midarubiccube/motordriver_board/3D/AZ1117CH-3.3TRG1.stp

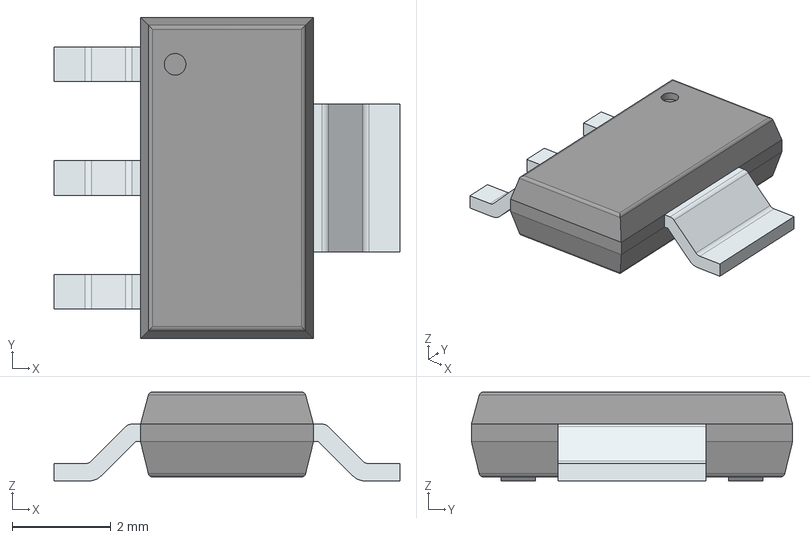
[picture p1: CAD file, 2024-08-10]
3D/AZ1117CH-3.3TRG1.stp
7.00 x 6.50 x 1.80 mm
PinsArrayL
FilletPinR
