midarubiccube/motordriver_board/3D/XT60PW-F--3DModel-STEP-510211.step

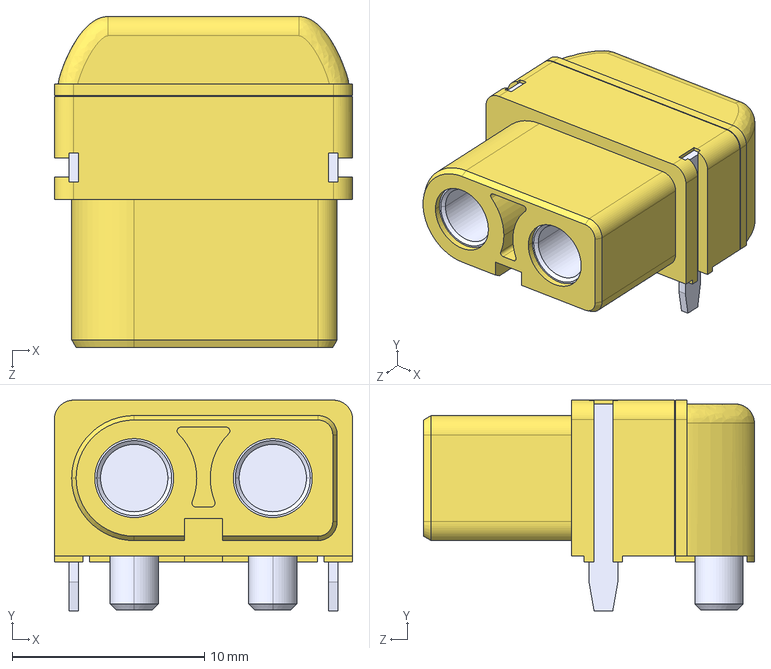
[picture p2: CAD file, 2024-08-10]
3D/XT60PW-F--3DModel-STEP-510211.step
15.5 x 10.9 x 17.2 mm
