midarubiccube/motordriver_board/3D/BP5293-50.stp

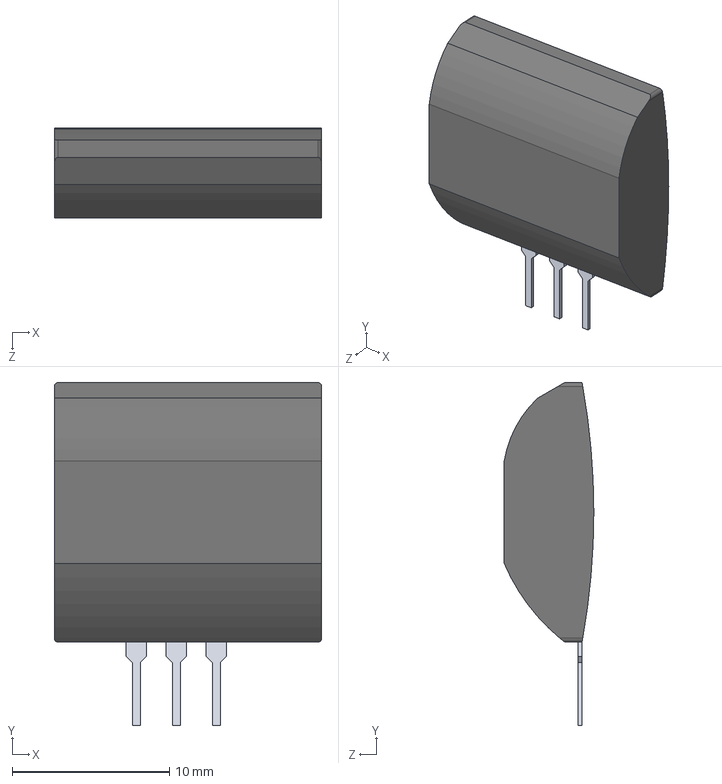
[picture p3: CAD file, 2024-08-10]
3D/BP5293-50.stp
17.0 x 21.8 x 5.70 mm
