midarubiccube/motordriver_board/motordriver_board.kicad_pcb

## KiCad design motordriver_board.kicad_pcb (2024-09-26)

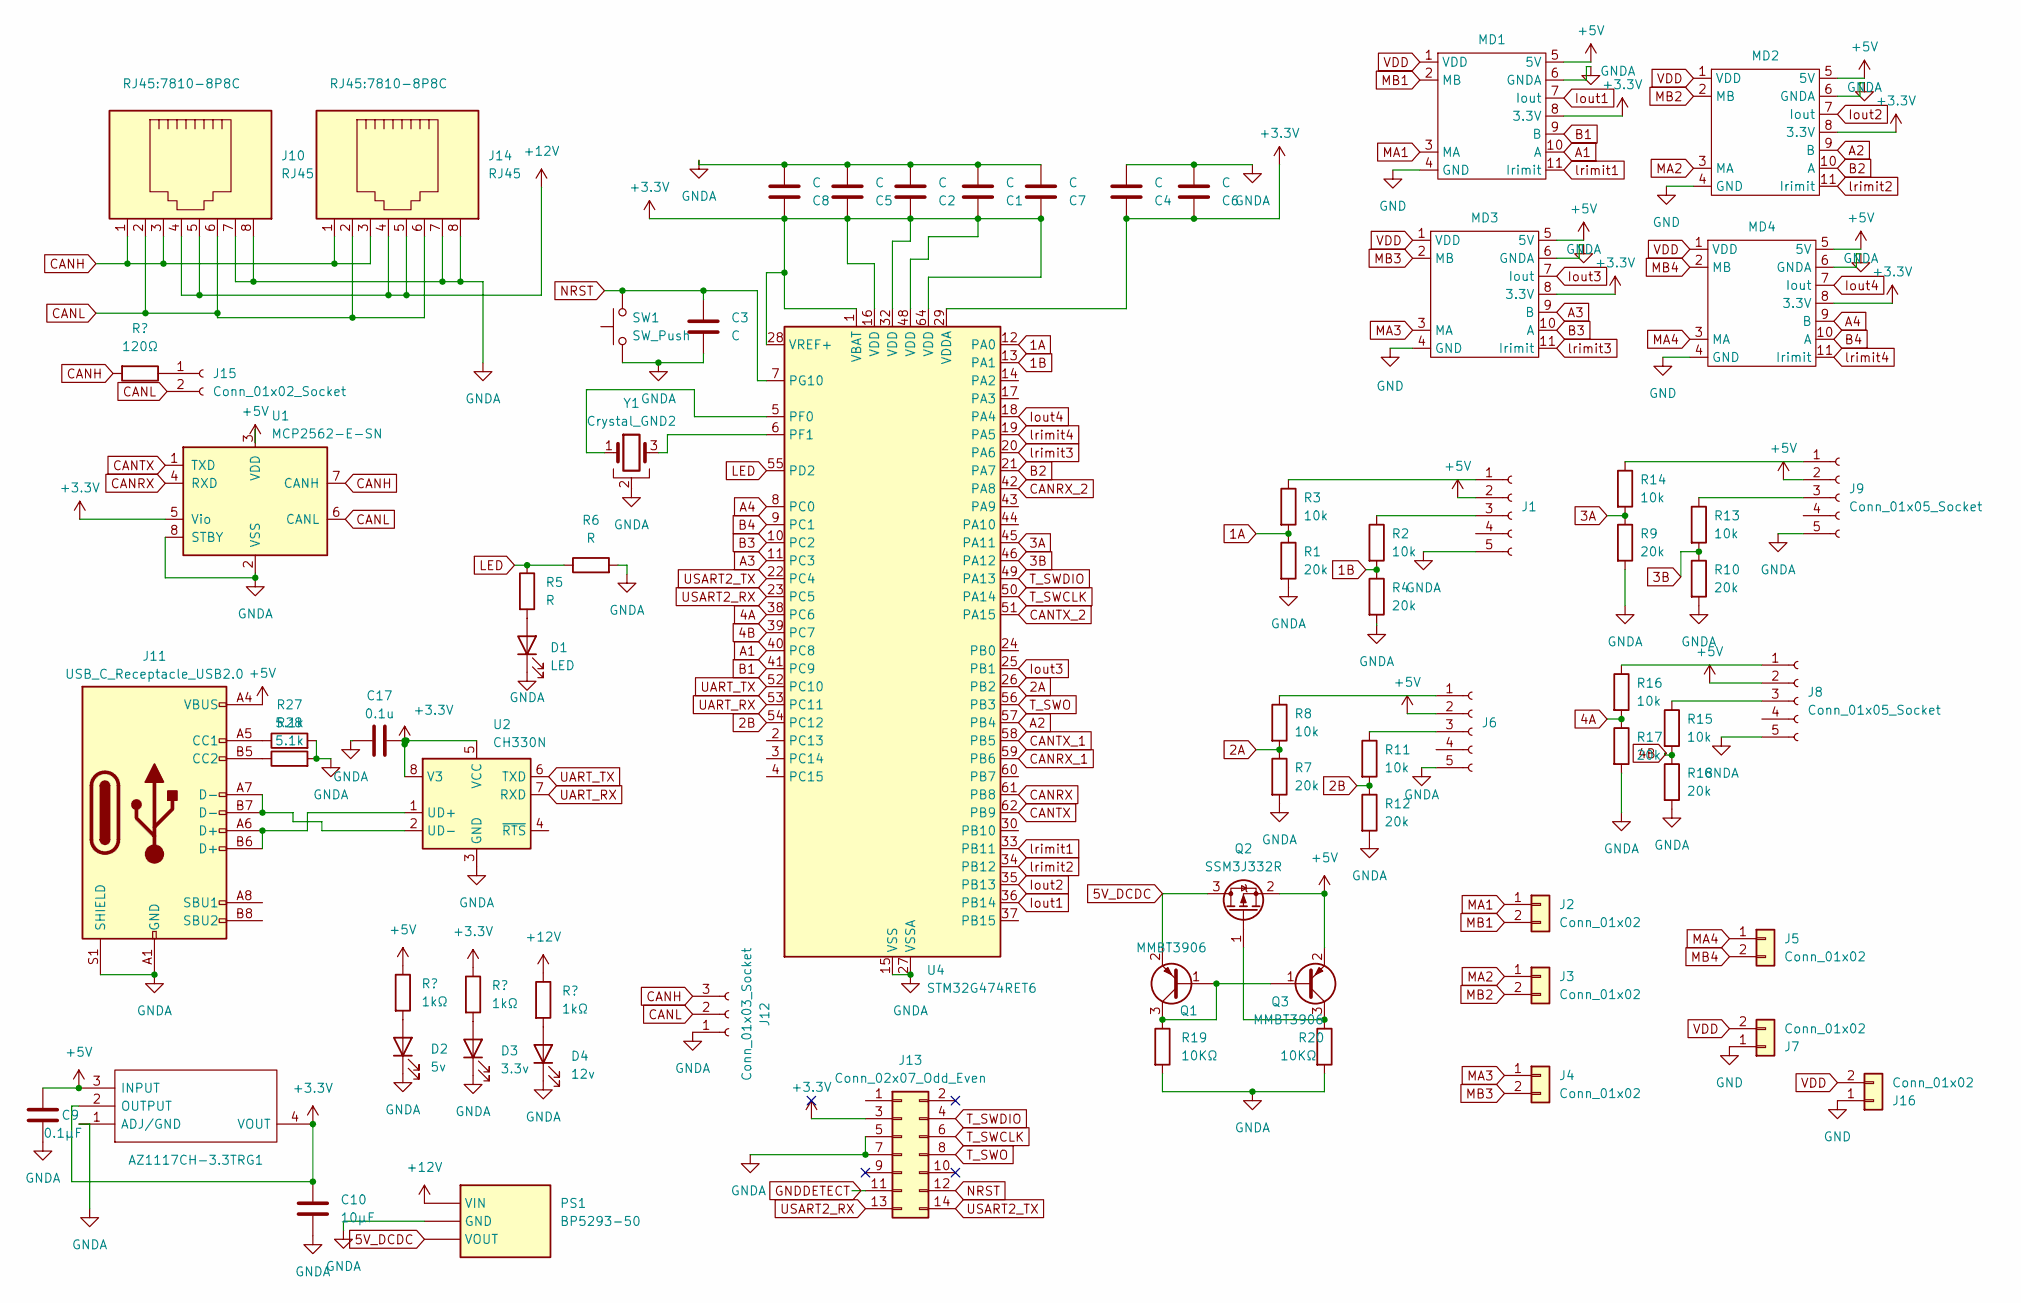
[picture p5: schematic motordriver_board.kicad_sch]

Parts:
C1, C2, C3, C4, C5, C6, C7, C8: C; C_0603_1608Metric_Pad1.08x0.95mm_HandSolder
C9: 0.1μF; C_0603_1608Metric_Pad1.08x0.95mm_HandSolder
C10: 10µF; C_0805_2012Metric_Pad1.18x1.45mm_HandSolder
C17: 0.1u; C_0603_1608Metric_Pad1.08x0.95mm_HandSolder; LCSC C14663
D1: LED; LED_0603_1608Metric_Pad1.05x0.95mm_HandSolder
D2: 5v; LED_0603_1608Metric_Pad1.05x0.95mm_HandSolder
D3: 3.3v; LED_0603_1608Metric_Pad1.05x0.95mm_HandSolder
D4: 12v; LED_0603_1608Metric_Pad1.05x0.95mm_HandSolder
IC1: AZ1117CH-3.3TRG1; SOT230P700X180-4N; Manufacturer_Part_Number AZ1117CH-3.3TRG1
J1, J6, J8, J9: Conn_01x05_Socket; JST_XH_B5B-XH-A_1x05_P2.50mm_Vertical
J2, J3, J4, J5: Conn_01x02; AMASS_XT60PW-F_1x02_P7.20mm_Horizontal
J7, J16: Conn_01x02; AMASS_XT60PW-M_1x02_P7.20mm_Horizontal
J10, J14: RJ45; 7810-8P8C
J11: USB_C_Receptacle_USB2.0; USB_C_Receptacle_HCTL_HC-TYPE-C-16P-01A
J12: Conn_01x03_Socket; PinHeader_1x03_P2.54mm_Vertical
J13: Conn_02x07_Odd_Even; connector
J15: Conn_01x02_Socket; PinHeader_1x02_P2.54mm_Vertical
MD1, MD2, MD3, MD4: MD_vetical
PS1: BP5293-50; TO254P570X1700X1780-3P; Manufacturer_Part_Number BP5293-50
Q1, Q3: MMBT3906; SOT-23
Q2: SSM3J332R; SOT-23
R1, R4, R7, R9, R10, R12, R17, R18: 20k; R_0603_1608Metric_Pad0.98x0.95mm_HandSolder
R2, R3, R8, R11, R13, R14, R15, R16: 10k; R_0603_1608Metric_Pad0.98x0.95mm_HandSolder
R5, R6: R; R_0603_1608Metric_Pad0.98x0.95mm_HandSolder
R19, R20: 10KΩ; R_0805_2012Metric_Pad1.20x1.40mm_HandSolder
R23, R24, R25: 1kΩ; R_0805_2012Metric_Pad1.20x1.40mm_HandSolder
R26: 120Ω; R_0805_2012Metric_Pad1.20x1.40mm_HandSolder
R27, R28: 5.1k; R_0603_1608Metric_Pad0.98x0.95mm_HandSolder; LCSC C23186
SW1: SW_Push; SW_PUSH_6mm_H5mm
U1: MCP2562-E-SN; SOIC-8_3.9x4.9mm_P1.27mm
U2: CH330N; SOIC-8_3.9x4.9mm_P1.27mm
U4: STM32G474RET6; LQFP-64_10x10mm_P0.5mm
Y1: Crystal_GND2; Resonator_SMD_Murata_CSTxExxV-3Pin_3.0x1.1mm_HandSoldering

Connections:
1A: R1.1, R3.2, U4.12 (PA0)
1B: R2.2, R4.1, U4.13 (PA1)
2A: R7.1, R8.2, U4.26 (PB2)
2B: R11.2, R12.1, U4.54 (PC12)
3A: R9.1, R14.2, U4.45 (PA11)
3B: R10.1, R13.2, U4.46 (PA12)
4A: R16.2, R17.1, U4.38 (PC6)
4B: R15.2, R18.1, U4.39 (PC7)
5V_DCDC: PS1.3 (VOUT), Q1.2 (E), Q2.3 (D)
+3.3V: C1.1, C2.1, C4.1, C5.1, C6.1, C7.1, C8.1, C10.1, IC1.2 (OUTPUT), IC1.4 (VOUT), J13.3, MD1.8 (3.3V), MD2.8 (3.3V), MD3.8 (3.3V), MD4.8 (3.3V), R24.1, U1.5 (Vio), U2.5 (VCC), U2.8 (V3), U4.1 (VBAT), U4.16 (VDD), U4.28 (VREF+), U4.29 (VDDA), U4.32 (VDD), U4.48 (VDD), U4.64 (VDD); also elsewhere on the board
+5V: C9.1, IC1.3 (INPUT), J1.2, J6.2, J8.2, J9.2, J11.A4 (VBUS), J11.A9 (VBUS), J11.B4 (VBUS), J11.B9 (VBUS), MD1.5 (5V), MD2.5 (5V), MD3.5 (5V), MD4.5 (5V), Q2.2 (S), Q3.2 (E), R23.1, U1.3 (VDD)
+12V: J10.4, J10.5, J14.4, J14.5, PS1.1 (VIN), R25.1
A1: MD1.10 (A), U4.40 (PC8)
A2: MD2.9 (B), U4.57 (PB4)
A3: MD3.9 (B), U4.11 (PC3)
A4: MD4.9 (B), U4.8 (PC0)
B1: MD1.9 (B), U4.41 (PC9)
B2: MD2.10 (A), U4.21 (PA7)
B3: MD3.10 (A), U4.10 (PC2)
B4: MD4.10 (A), U4.9 (PC1)
CANH: J10.1, J10.3, J12.3, J14.1, J14.3, R26.2, U1.7 (CANH)
CANL: J10.2, J10.6, J12.2, J14.2, J14.6, J15.2, U1.6 (CANL)
CANRX: U1.4 (RXD), U4.61 (PB8)
CANRX_1: U4.59 (PB6)
CANRX_2: U4.42 (PA8)
CANTX: U1.1 (TXD), U4.62 (PB9)
CANTX_1: U4.58 (PB5)
CANTX_2: U4.51 (PA15)
GND: J7.1, J16.1, MD1.4 (GND), MD2.4 (GND), MD3.4 (GND), MD4.4 (GND)
GNDA: C1.2, C2.2, C3.2, C4.2, C5.2, C6.2, C7.2, C8.2, C9.2, C10.2, D1.1 (K), D2.1 (K), D3.1 (K), D4.1 (K), IC1.1 (ADJ/GND), J1.5, J6.5, J8.5, J9.5, J10.7, J10.8, J11.A1 (GND), J11.A12 (GND), J11.B1 (GND), J11.B12 (GND), J11.S1 (SHIELD), J12.1, J13.5, J13.7, J14.7, J14.8, MD1.6 (GNDA), MD2.6 (GNDA), MD3.6 (GNDA), MD4.6 (GNDA), PS1.2 (GND), R1.2, R4.2, R6.2, R7.2, R9.2, R10.2, R12.2, R17.2, R18.2, R19.2, R20.2, SW1.1, U1.2 (VSS), U1.8 (STBY), U2.3 (GND), U4.15 (VSS), U4.27 (VSSA), U4.31 (VSS), U4.47 (VSS), U4.63 (VSS), Y1.2; also elsewhere on the board
GNDDETECT: J13.11
Iout1: MD1.7 (Iout), U4.36 (PB14)
Iout2: MD2.7 (Iout), U4.35 (PB13)
Iout3: MD3.7 (Iout), U4.25 (PB1)
Iout4: MD4.7 (Iout), U4.18 (PA4)
LED: R5.1, R6.1, U4.55 (PD2)
MA1: J2.1, MD1.3 (MA)
MA2: J3.1, MD2.3 (MA)
MA3: J4.1, MD3.3 (MA)
MA4: J5.1, MD4.3 (MA)
MB1: J2.2, MD1.2 (MB)
MB2: J3.2, MD2.2 (MB)
MB3: J4.2, MD3.2 (MB)
MB4: J5.2, MD4.2 (MB)
NRST: C3.1, J13.12, SW1.2, U4.7 (PG10)
unnamed: D1.2 (A), R5.2
unnamed: D2.2 (A), R23.2
unnamed: D3.2 (A), R24.2
unnamed: D4.2 (A), R25.2
unnamed: J1.1, R3.1
unnamed: J1.3, R2.1
unnamed: J6.1, R8.1
unnamed: J6.3, R11.1
unnamed: J8.1, R16.1
unnamed: J8.3, R15.1
unnamed: J9.1, R14.1
unnamed: J9.3, R13.1
unnamed 57: J11.A5 (CC1); also elsewhere on the board
unnamed 58: J11.B5 (CC2); also elsewhere on the board
unnamed: J15.1, R26.1
unnamed: Q1.1 (B), Q1.3 (C), Q3.1 (B), R19.1
unnamed: Q2.1 (G), Q3.3 (C), R20.1
unnamed: J11.A6 (D+), J11.B6 (D+), U2.1 (UD+)
unnamed: J11.A7 (D-), J11.B7 (D-), U2.2 (UD-)
unnamed: U4.5 (PF0), Y1.1
unnamed: U4.6 (PF1), Y1.3
T_SWCLK: J13.6, U4.50 (PA14)
T_SWDIO: J13.4, U4.49 (PA13)
T_SWO: J13.8, U4.56 (PB3)
UART_RX: U2.7 (RXD), U4.53 (PC11)
UART_TX: U2.6 (TXD), U4.52 (PC10)
USART2_RX: J13.13, U4.23 (PC5)
USART2_TX: J13.14, U4.22 (PC4)
VDD: J7.2, J16.2, MD1.1 (VDD), MD2.1 (VDD), MD3.1 (VDD), MD4.1 (VDD)
lrimit1: MD1.11 (Irimit), U4.33 (PB11)
lrimit2: MD2.11 (Irimit), U4.34 (PB12)
lrimit3: MD3.11 (Irimit), U4.20 (PA6)
lrimit4: MD4.11 (Irimit), U4.19 (PA5)

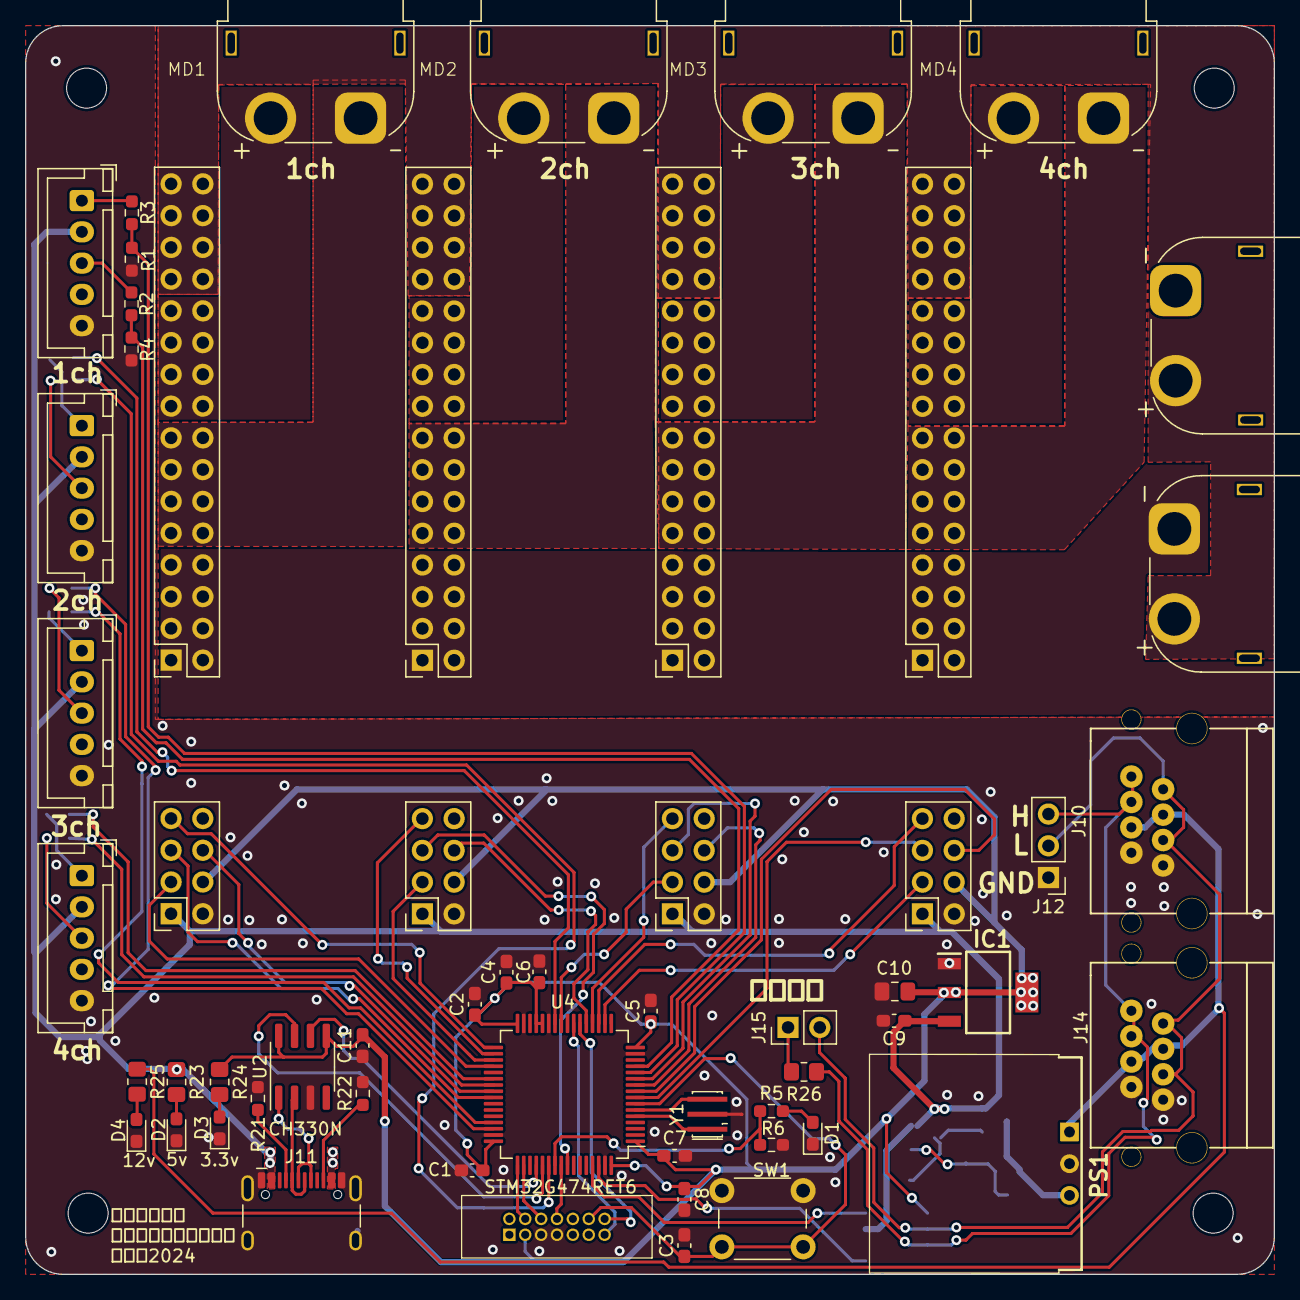
[picture p6: board motordriver_board.kicad_pcb from above]

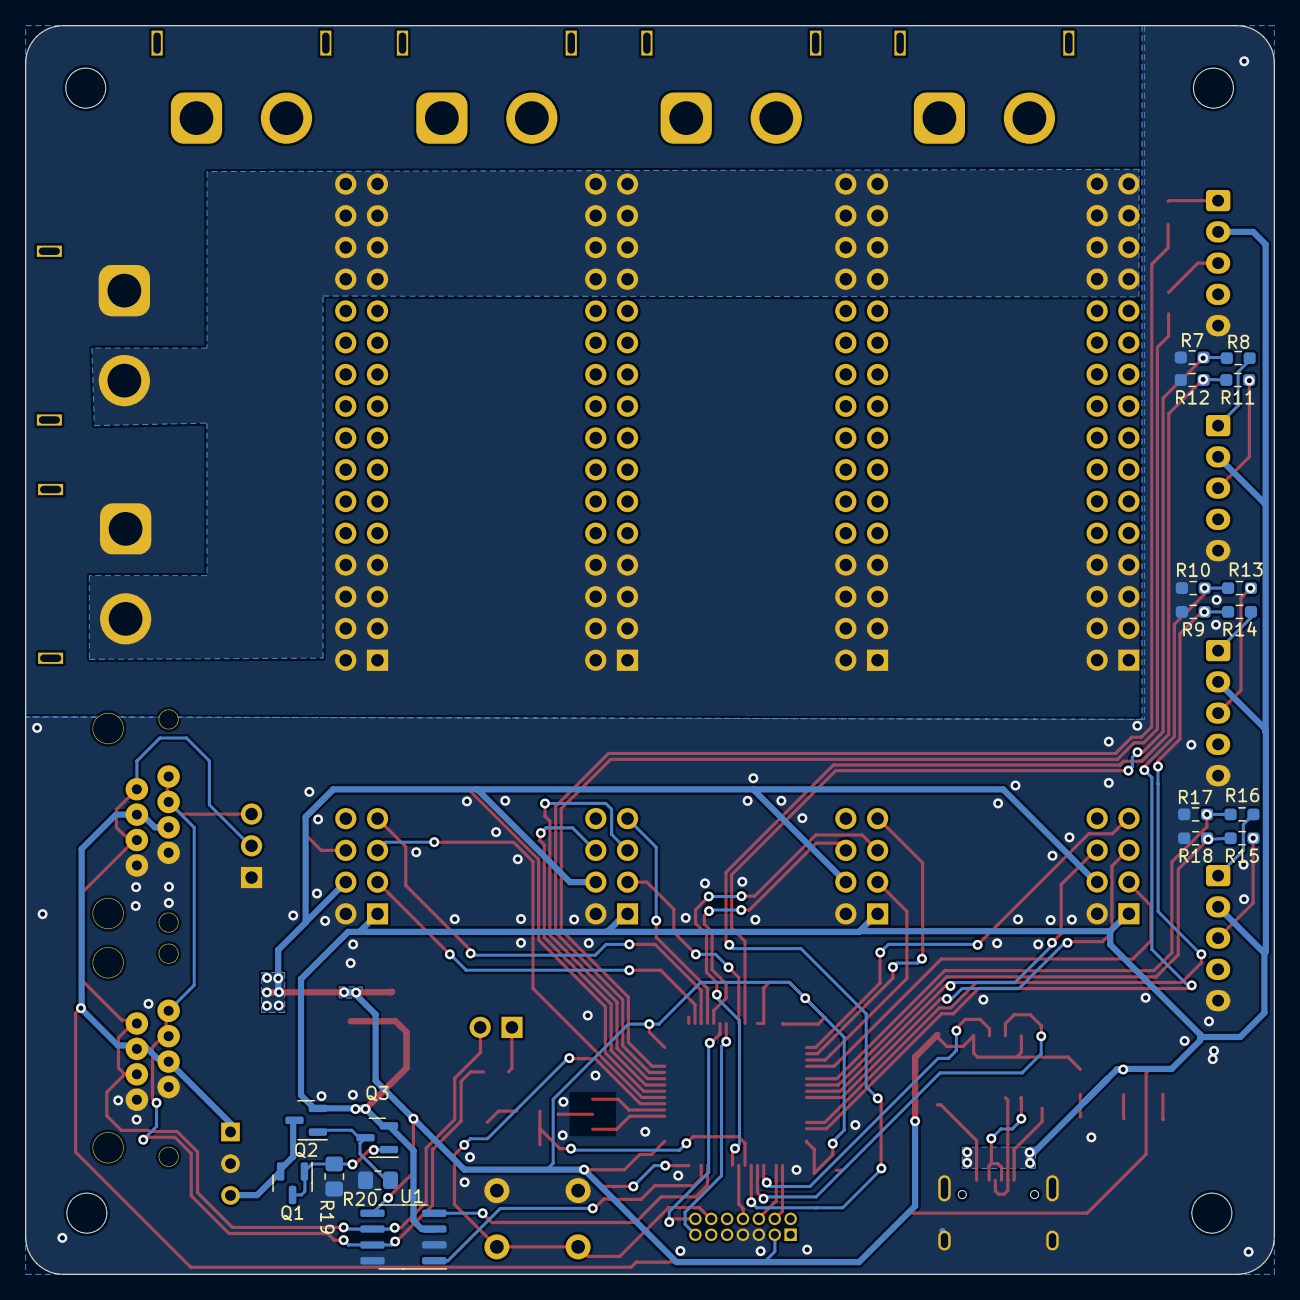
[picture p7: board motordriver_board.kicad_pcb from below]

Board: 2 copper layers, 99.9 x 99.9 mm, 71 parts (18 on the bottom side), 73 nets.

Other parts of the board:
C11: 0.1u; C_0603_1608Metric_Pad1.08x0.95mm_HandSolder
R21, R22: 5.1k; R_0603_1608Metric_Pad0.98x0.95mm_HandSolder

Their connections:
+3.3V: C11.2; also elsewhere on the board
GNDA: C11.1, R21.2, R22.2; also elsewhere on the board
unnamed 57: R21.1; also elsewhere on the board
unnamed 58: R22.1; also elsewhere on the board
