midarubiccube/motordriver_board/(commit log)

2024-08-10 init commit
    [AZ1117CH-3.3TRG1.stp, BP5293-50.stp, HRO_TYPE-C-31-M-12.step, XT60PW-F--3DModel-STEP-510211.step, motordriver_board.kicad_pcb, motordriver_board.kicad_sch]
2024-09-26 並列にXT60追加
    [motordriver_board.kicad_pcb, motordriver_board.kicad_sch]
